savec/seismo/layout/seismo.brd

## EAGLE design layout/seismo.brd (2015-05-20)

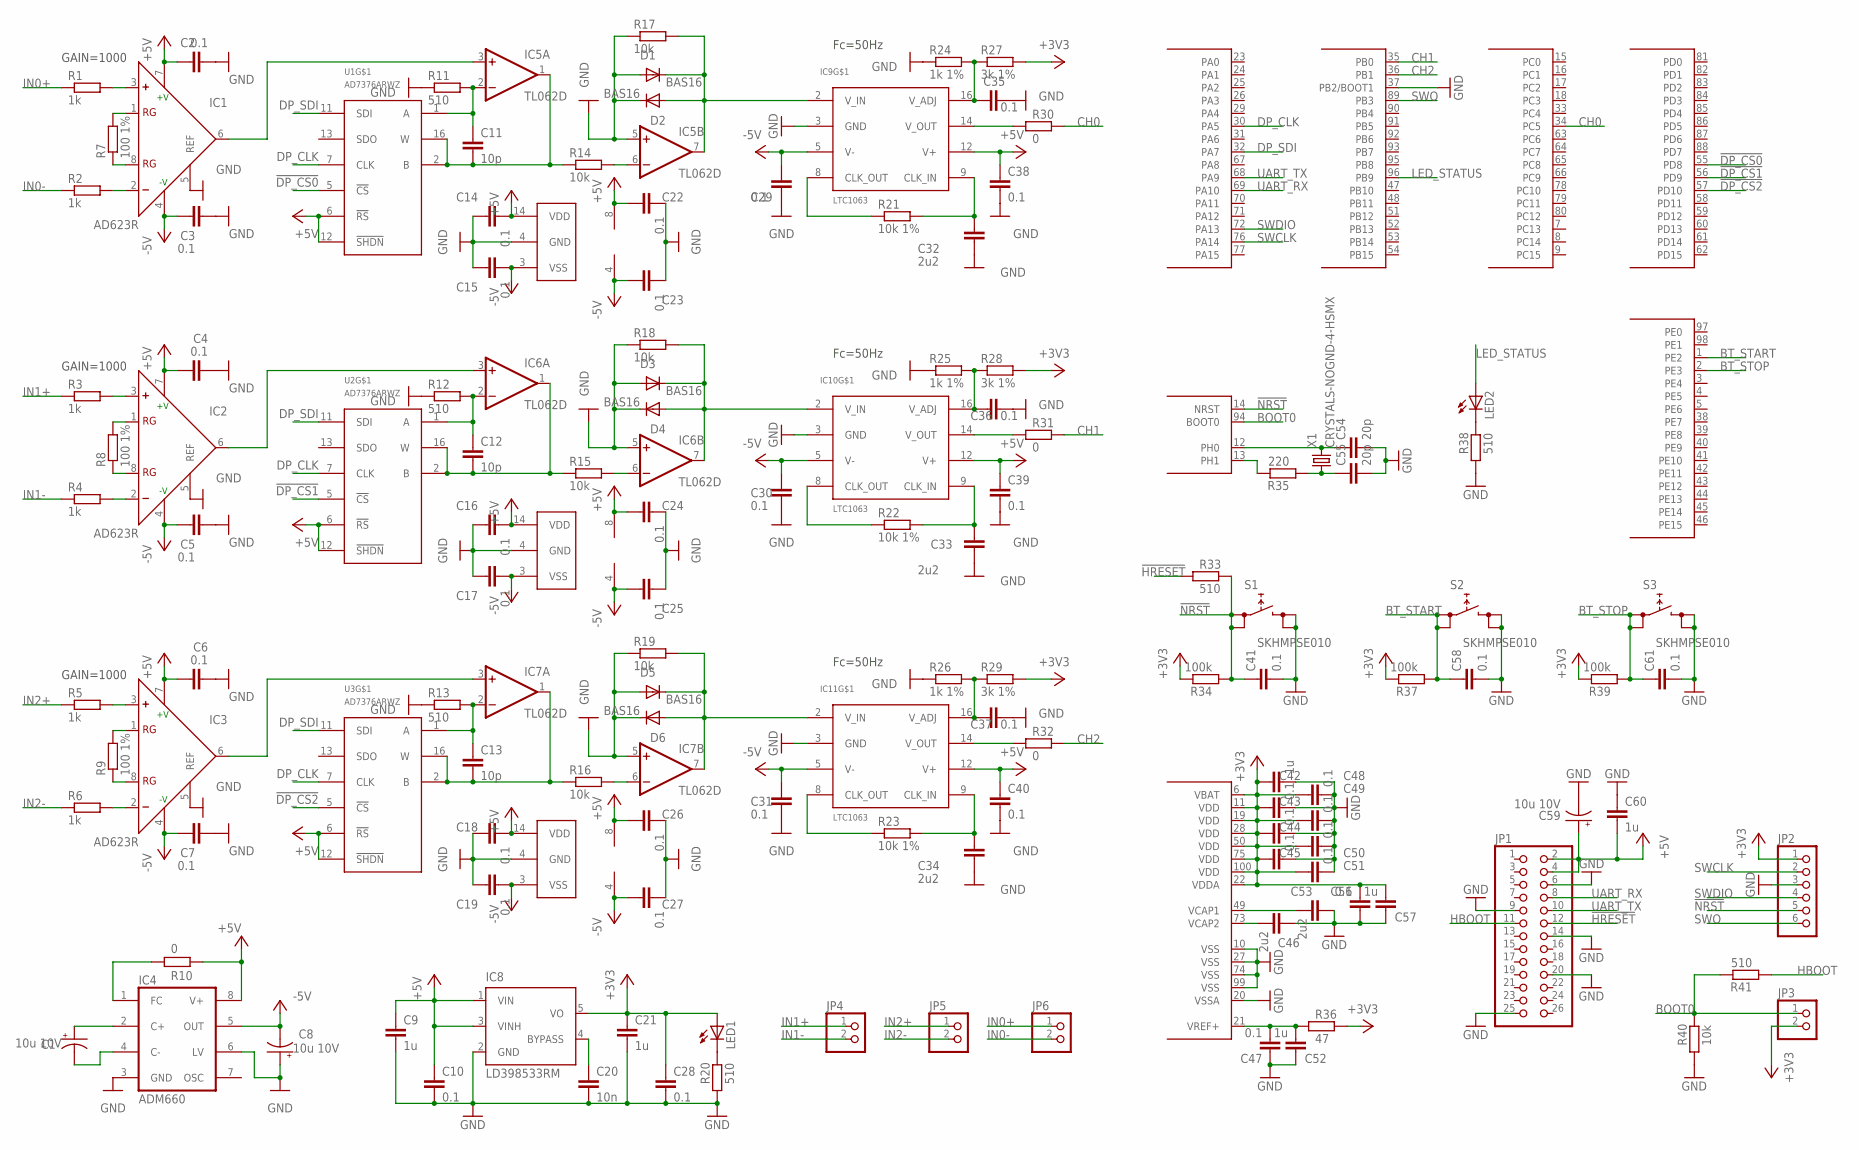
[picture p1: schematic seismo.sch]

Parts:
C1, C8, C59: 10u 10V; SMC_A
C2, C3, C4, C5, C6, C7, C10, C14, C15, C16, C17, C18, C19, C22, C23, C24, C25, C26, C27, C28, C29, C30, C31, C35, C36, C37, C38, C39, C40, C41, C43, C44, C45, C47, C48, C49, C50, C51, C56, C58, C61: 0.1; C0805
C9, C21, C42, C52, C57, C60: 1u; C0805
C11, C12, C13: 10p; C0805
C20: 10n; C0805
C32, C33, C34, C46, C53: 2u2; C0805
C54, C55: 20p; C0805
D1, D2, D3, D4, D5, D6: BAS16; SOT23
IC1, IC2, IC3: AD623R; SO8
IC4: ADM660; SO8
IC5, IC6, IC7: TL062D; SO08
IC8: LD398533RM; SOT23-5L
IC9, IC10, IC11: LTC1063; SOIC127P1032X264-16N
JP1: PINHD-2X13; 2X13
JP2: PINHD-1X6; 1X06
JP3, JP4, JP5, JP6: PINHD-1X2; 1X02
LED1, LED2: LEDCHIPLED_1206; CHIPLED_1206
R1, R2, R3, R4, R5, R6: 1k; R0805W
R7, R8, R9: 100 1%; R0805W
R10, R30, R31, R32: 0; R0805W
R11, R12, R13, R20, R33, R38, R41: 510; R0805W
R14, R15, R16, R17, R18, R19, R40: 10k; R0805W
R21, R22, R23: 10k 1%; R0805W
R24, R25, R26: 1k 1%; R0805W
R27, R28, R29: 3k 1%; R0805W
R34, R37, R39: 100k; R0805W
R35: 220; R0805W
R36: 47; R0805W
S1, S2, S3: SKHMPSE010; SKHMPXE010
U1, U2, U3: AD7376ARWZ; SO-16W
U4: STM32F4-100; SQFP-S-14X14-100
X1: CRYSTALS-NOGND-4-HSMX; HC49-4-HSMX

Connections:
!DP_CS0: U1.5 (!CS), U4.55 (PD8)
!DP_CS1: U2.5 (!CS), U4.56 (PD9)
!DP_CS2: U3.5 (!CS), U4.57 (PD10)
!HRESET: JP1.12, R33.1
!NRST: C41.1, JP2.5, R33.2, R34.1, S1.1 (1.1), S1.2 (1.2), U4.14 (NRST)
+3V3: C21.1, C28.1, C42.1, C43.1, C44.1, C45.1, C48.1, C49.1, C50.1, C51.1, C56.2, C57.2, IC8.5 (VO), JP2.1, JP3.2, LED1.A, R27.2, R28.2, R29.2, R34.2, R36.2, R37.2, R39.2, U4.6 (VBAT), U4.11 (VDD), U4.19 (VDD), U4.22 (VDDA), U4.28 (VDD), U4.50 (VDD), U4.75 (VDD), U4.100 (VDD)
+5V: C2.1, C4.1, C6.1, C9.1, C10.1, C14.2, C16.2, C18.2, C22.1, C24.1, C26.1, C38.1, C39.1, C40.1, C59.+, C60.2, IC1.7 (+V), IC2.7 (+V), IC3.7 (+V), IC4.8 (V+), IC5.8 (V+), IC6.8 (V+), IC7.8 (V+), IC8.1 (VIN), IC8.3 (VINH), IC9.12 (V+), IC10.12 (V+), IC11.12 (V+), JP1.2, JP1.4, R10.2, U1.6 (!RS), U1.12 (!SHDN), U1.14 (VDD), U2.6 (!RS), U2.12 (!SHDN), U2.14 (VDD), U3.6 (!RS), U3.12 (!SHDN), U3.14 (VDD)
-5V: C3.1, C5.1, C7.1, C8.-, C15.2, C17.2, C19.2, C23.1, C25.1, C27.1, C29.1, C30.1, C31.1, IC1.4 (-V), IC2.4 (-V), IC3.4 (-V), IC4.5 (OUT), IC5.4 (V-), IC6.4 (V-), IC7.4 (V-), IC9.5 (V-), IC10.5 (V-), IC11.5 (V-), U1.3 (VSS), U2.3 (VSS), U3.3 (VSS)
BOOT0: JP3.1, R40.2, R41.2, U4.94 (BOOT0)
BT_START: C58.1, R37.1, S2.1 (1.1), S2.2 (1.2), U4.1 (PE2)
BT_STOP: C61.1, R39.1, S3.1 (1.1), S3.2 (1.2), U4.2 (PE3)
CH0: R30.2, U4.34 (PC5)
CH1: R31.2, U4.35 (PB0)
CH2: R32.2, U4.36 (PB1)
DP_CLK: U1.7 (CLK), U2.7 (CLK), U3.7 (CLK), U4.30 (PA5)
DP_SDI: U1.11 (SDI), U2.11 (SDI), U3.11 (SDI), U4.32 (PA7)
GND: C2.2, C3.2, C4.2, C5.2, C6.2, C7.2, C8.+, C9.2, C10.2, C14.1, C15.1, C16.1, C17.1, C18.1, C19.1, C20.2, C21.2, C22.2, C23.2, C24.2, C25.2, C26.2, C27.2, C28.2, C29.2, C30.2, C31.2, C32.2, C33.2, C34.2, C35.2, C36.2, C37.2, C38.2, C39.2, C40.2, C41.2, C42.2, C43.2, C44.2, C45.2, C46.1, C47.1, C48.2, C49.2, C50.2, C51.2, C52.1, C53.1, C54.2, C55.2, C56.1, C57.1, C58.2, C59.-, C60.1, C61.2, D1.1 (A), D2.3 (C), D3.1 (A), D4.3 (C), D5.1 (A), D6.3 (C), IC1.5 (REF), IC2.5 (REF), IC3.5 (REF), IC4.3 (GND), IC4.6 (LV), IC5.5 (+IN), IC6.5 (+IN), IC7.5 (+IN), IC8.2 (GND), IC9.3 (GND), IC10.3 (GND), IC11.3 (GND), JP1.6, JP1.9, JP1.14, JP1.20, JP1.25, JP2.3, R11.1, R12.1, R13.1, R17.1, R18.1, R19.1, R20.1, R24.1, R25.1, R26.1, R38.1, R40.1, S1.3 (2.1), S1.4 (2.2), S2.3 (2.1), S2.4 (2.2), S3.3 (2.1), S3.4 (2.2), U1.4 (GND), U2.4 (GND), U3.4 (GND), U4.10 (VSS), U4.20 (VSSA), U4.27 (VSS), U4.37 (PB2/BOOT1), U4.74 (VSS), U4.99 (VSS)
HBOOT: JP1.11, R41.1
IN0+: JP6.1, R1.1
IN0-: JP6.2, R2.1
IN1+: JP4.1, R3.1
IN1-: JP4.2, R4.1
IN2+: JP5.1, R5.1
IN2-: JP5.2, R6.1
LED_STATUS: LED2.A, U4.96 (PB9)
unnamed: IC1.2 (-), R2.2
unnamed: IC1.8 (RG), R7.1
unnamed: IC1.1 (RG), R7.2
unnamed: IC1.3 (+), R1.2
unnamed: C55.1, R35.1, X1.1
unnamed: IC9.8 (CLK_OUT), R21.1
unnamed: C32.1, IC9.9 (CLK_IN), R21.2
unnamed: C35.1, IC9.16 (V_ADJ), R24.2, R27.1
unnamed: R35.2, U4.13 (PH1)
unnamed: IC9.14 (V_OUT), R30.1
unnamed: C1.+, IC4.2 (C+)
unnamed: IC10.8 (CLK_OUT), R22.1
unnamed: C33.1, IC10.9 (CLK_IN), R22.2
unnamed: IC2.2 (-), R4.2
unnamed: IC2.8 (RG), R8.1
unnamed: IC2.1 (RG), R8.2
unnamed: IC2.3 (+), R3.2
unnamed: C36.1, IC10.16 (V_ADJ), R25.2, R28.1
unnamed: IC10.14 (V_OUT), R31.1
unnamed: C1.-, IC4.4 (C-)
unnamed: C53.2, U4.49 (VCAP1)
unnamed: IC11.8 (CLK_OUT), R23.1
unnamed: C34.1, IC11.9 (CLK_IN), R23.2
unnamed: IC3.2 (-), R6.2
unnamed: IC3.8 (RG), R9.1
unnamed: IC3.1 (RG), R9.2
unnamed: IC3.3 (+), R5.2
unnamed: C37.1, IC11.16 (V_ADJ), R26.2, R29.1
unnamed: IC11.14 (V_OUT), R32.1
unnamed: IC4.1 (FC), R10.1
unnamed: C11.2, IC5.1 (OUT), R14.1, U1.2 (B), U1.16 (W)
unnamed: IC1.6 (OUT), IC5.3 (+IN)
unnamed: C11.1, IC5.2 (-IN), R11.2, U1.1 (A)
unnamed: IC5.6 (-IN), R14.2
unnamed: C20.1, IC8.4 (BYPASS)
unnamed: D1.3 (C), D2.1 (A), IC5.7 (OUT), IC9.2 (V_IN), R17.2
unnamed: C46.2, U4.73 (VCAP2)
unnamed: C12.2, IC6.1 (OUT), R15.1, U2.2 (B), U2.16 (W)
unnamed: IC2.6 (OUT), IC6.3 (+IN)
unnamed: C12.1, IC6.2 (-IN), R12.2, U2.1 (A)
unnamed: IC6.6 (-IN), R15.2
unnamed: D3.3 (C), D4.1 (A), IC6.7 (OUT), IC10.2 (V_IN), R18.2
unnamed: C13.2, IC7.1 (OUT), R16.1, U3.2 (B), U3.16 (W)
unnamed: IC3.6 (OUT), IC7.3 (+IN)
unnamed: C13.1, IC7.2 (-IN), R13.2, U3.1 (A)
unnamed: IC7.6 (-IN), R16.2
unnamed: D5.3 (C), D6.1 (A), IC7.7 (OUT), IC11.2 (V_IN), R19.2
unnamed: C54.1, U4.12 (PH0), X1.2
unnamed: LED1.C, R20.2
unnamed: LED2.C, R38.2
SWCLK: JP2.2, U4.76 (PA14)
SWDIO: JP2.4, U4.72 (PA13)
SWO: JP2.6, U4.89 (PB3)
UART_RX: JP1.8, U4.69 (PA10)
UART_TX: JP1.10, U4.68 (PA9)
VREF: C47.2, C52.2, R36.1, U4.21 (VREF+)

Notes on the sheet:
GAIN=1000
Fc=50Hz

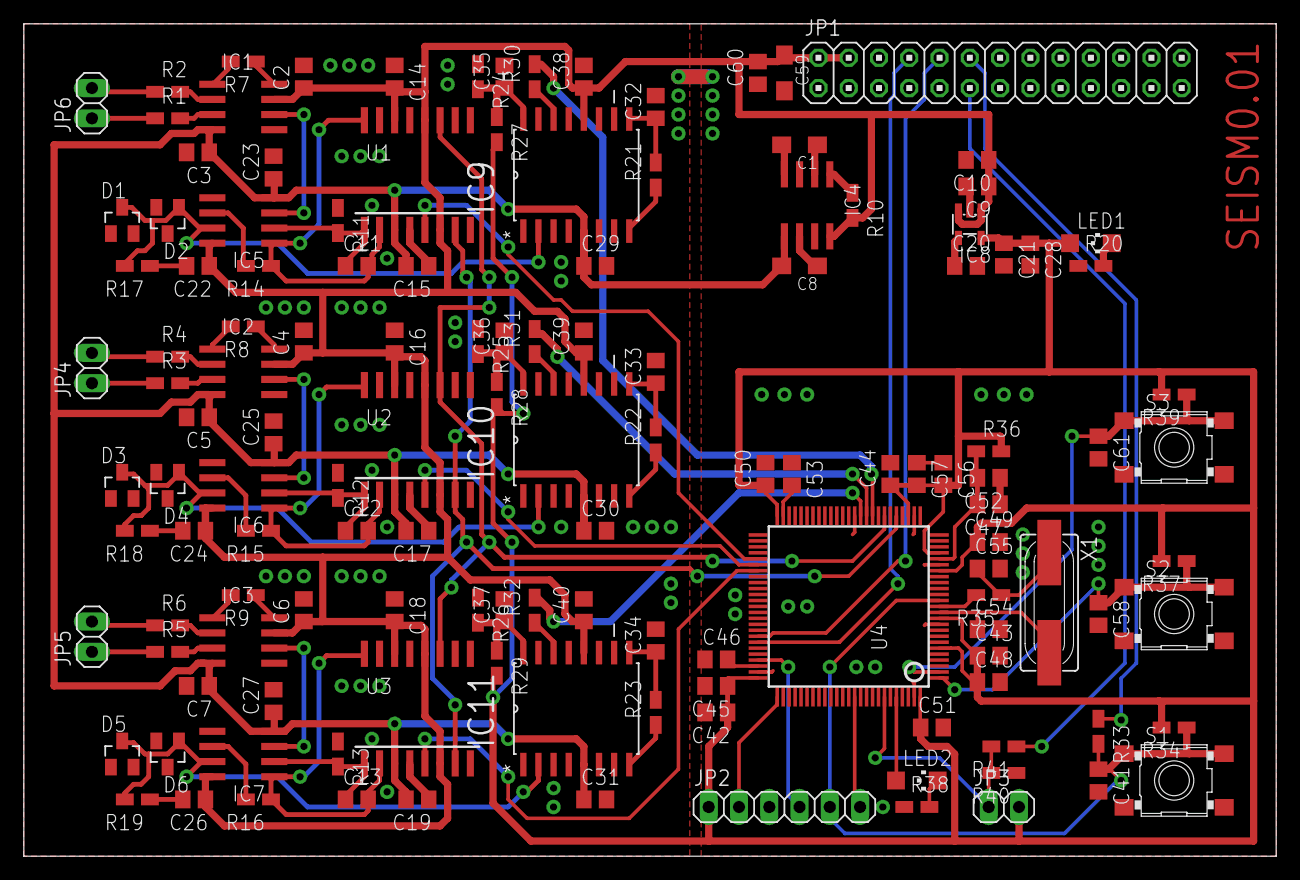
[picture p2: board seismo.brd from above]

Board: 2 copper layers, 105.1 x 69.8 mm, 135 parts (0 on the bottom side), 81 nets.
