savec/seismo/signal_board/signal_board.ioc

Mcu.UserName=STM32F407VGTx
PA10.Signal=USART1_RX
PA13.Signal=SYS_JTMS-SWDIO
PA14.Signal=SYS_JTCK-SWCLK
PA5.Signal=SPI1_SCK
PA7.Signal=SPI1_MOSI
PA9.Signal=USART1_TX
PB0.Signal=ADCx_IN8
PB1.Signal=ADCx_IN9
PB3.Signal=SYS_JTDO-SWO
PB9.Signal=GPIO_Output
PC5.Signal=ADCx_IN15
PD10.Signal=GPIO_Output
PD8.Signal=GPIO_Output
PD9.Signal=GPIO_Output
PE2.Signal=GPIO_Input
PE3.Signal=GPIO_Input
PH0-OSC_IN.Signal=RCC_OSC_IN
PH1-OSC_OUT.Signal=RCC_OSC_OUT
