savec/seismo/(commit log)

2015-05-27 adc channels & tim
2015-05-27 prepare to launch adc
2015-05-27 adc clock divider
2015-06-13 usart tx dma
2015-06-13 packet sending over dma
2015-06-14 packets unstuffing; bugs fixed
    [main.c]
